JoeyShepard/RPN_Calculator/images/RPN_calculator_schematic.png

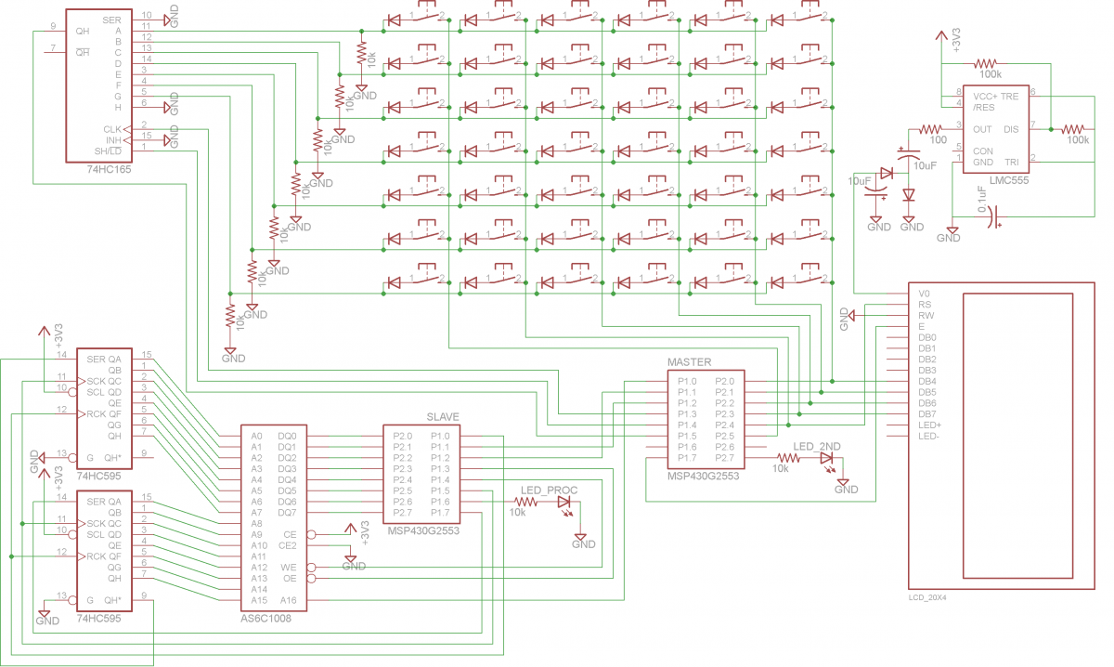
images/RPN_calculator_schematic.png
