JoeyShepard/RPN_Calculator/schematics/main.png

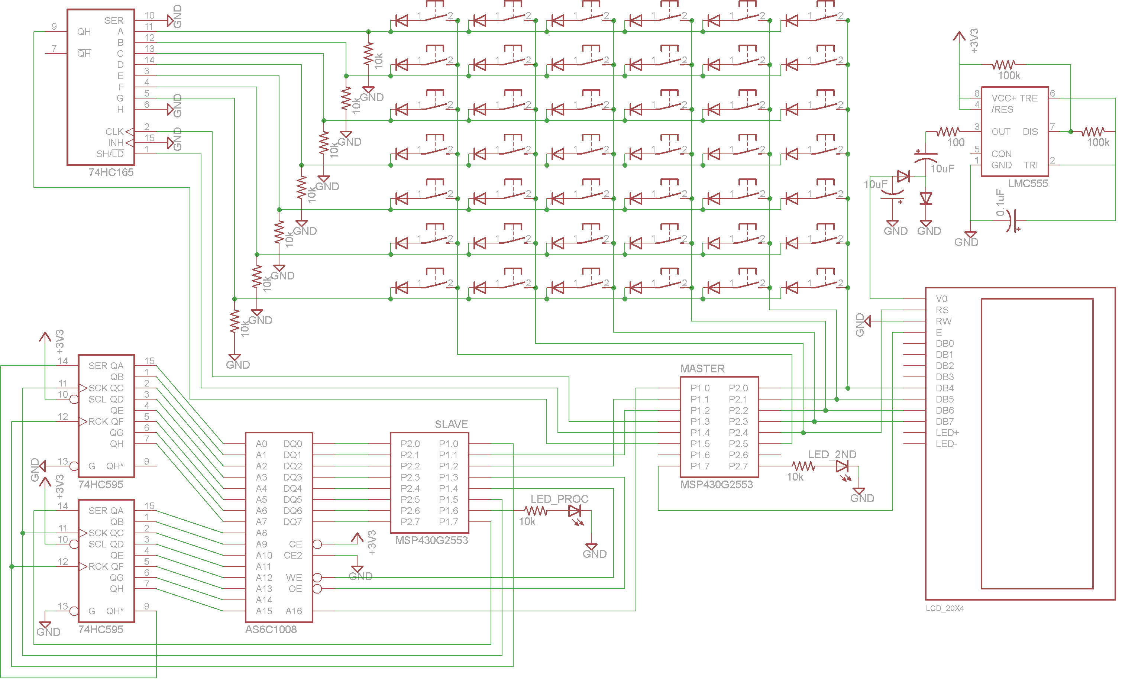
schematics/main.png
