JoeyShepard/RPN_Calculator/schematics/circuit_layout.sch

## EAGLE design schematics/circuit_layout.sch (2020-10-12)

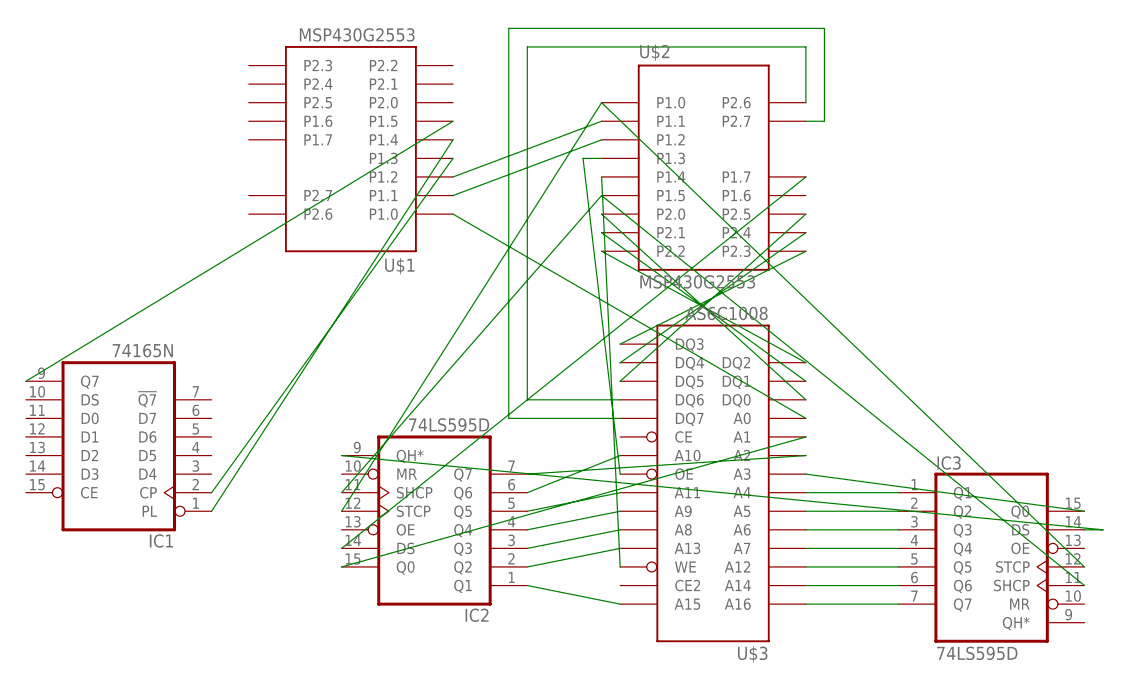
[picture p7: schematic circuit_layout.sch]

Parts:
IC1: 74165N; DIL16
IC2, IC3: 74LS595D; SO16
U$1, U$2: MSP430G2553
U$3: AS6C1008

Connections:
unnamed: IC3.7 (Q7), U$3.P$17 (A16)
unnamed: IC3.6 (Q6), U$3.P$15 (A14)
unnamed: IC3.5 (Q5), U$3.P$13 (A12)
unnamed: IC3.4 (Q4), U$3.P$8 (A7)
unnamed: IC3.3 (Q3), U$3.P$7 (A6)
unnamed: IC3.2 (Q2), U$3.P$6 (A5)
unnamed: IC3.1 (Q1), U$3.P$5 (A4)
unnamed: IC3.15 (Q0), U$3.P$4 (A3)
unnamed: IC2.1 (Q1), U$3.P$16 (A15)
unnamed: IC2.2 (Q2), U$3.P$14 (A13)
unnamed: IC2.3 (Q3), U$3.P$9 (A8)
unnamed: IC2.4 (Q4), U$3.P$10 (A9)
unnamed: IC2.5 (Q5), U$3.P$12 (A11)
unnamed: IC2.6 (Q6), U$3.P$11 (A10)
unnamed: IC2.7 (Q7), U$3.P$3 (A2)
unnamed: IC2.15 (Q0), U$3.P$2 (A1)
unnamed: U$2.P$9 (P2.0), U$3.P$20 (DQ0)
unnamed: U$2.P$10 (P2.1), U$3.P$21 (DQ1)
unnamed: U$2.P$11 (P2.2), U$3.P$22 (DQ2)
unnamed: U$2.P$12 (P2.3), U$3.P$23 (DQ3)
unnamed: U$2.P$13 (P2.4), U$3.P$24 (DQ4)
unnamed: U$2.P$14 (P2.5), U$3.P$25 (DQ5)
unnamed: U$2.P$15 (P2.6), U$3.P$26 (DQ6)
unnamed: U$2.P$16 (P2.7), U$3.P$27 (DQ7)
unnamed: IC2.9 (QH*), IC3.14 (DS)
unnamed: IC2.11 (SHCP), IC3.11 (SHCP), U$2.P$6 (P1.5)
unnamed: U$2.P$5 (P1.4), U$3.P$29 (WE)
unnamed: U$2.P$4 (P1.3), U$3.P$28 (OE)
unnamed: U$1.P$3 (P1.2), U$2.P$2 (P1.1)
unnamed: U$1.P$2 (P1.1), U$2.P$3 (P1.2)
unnamed: IC2.12 (STCP), IC3.12 (STCP), U$2.P$1 (P1.0)
unnamed: U$1.P$1 (P1.0), U$3.P$1 (A0)
unnamed: IC1.2 (CP), U$1.P$4 (P1.3)
unnamed: IC1.1 (PL), U$1.P$5 (P1.4)
unnamed: IC1.9 (Q7), U$1.P$6 (P1.5)
unnamed: IC2.14 (DS), U$2.P$8 (P1.7)
