JoeyShepard/RPN_Calculator/schematics/main.sch

## EAGLE design schematics/main.sch (2020-10-12)

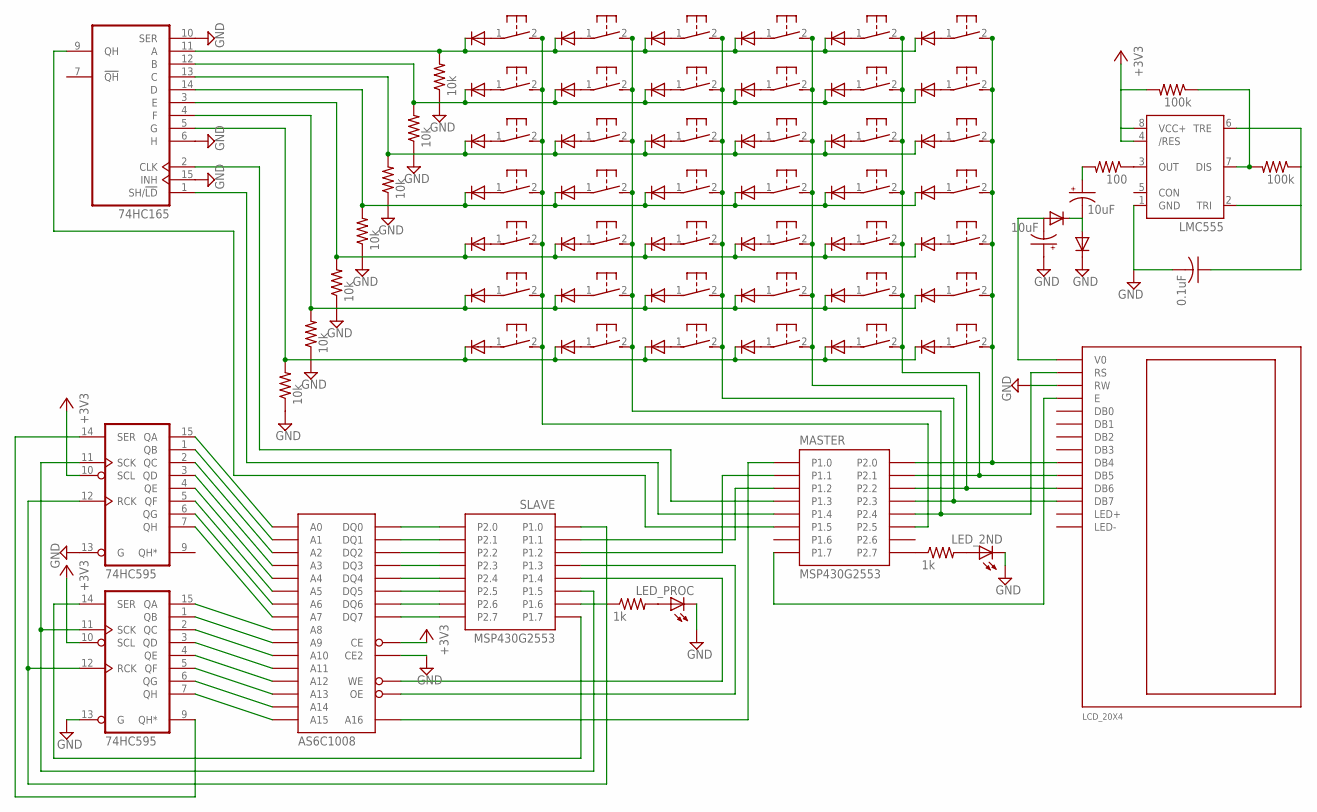
[picture p8: schematic main.sch]

Parts:
C2: 0.1uF; C025-024X044
C4, C5: 10uF; 085CS_1AW
D1, D2, D3, D4, D5, D6, D7, D8, D9, D10, D11, D12, D13, D14, D15, D16, D17, D18, D19, D20, D21, D22, D23, D24, D25, D26, D27, D28, D29, D30, D31, D32, D33, D34, D35, D36, D37, D38, D39, D40, D41, D42, D45, D46: 1N4148DO35-7; DO35-7
IC1: 74HC165; DIL16
IC2: LMC555; DIL-08
IC3, IC4: 74HC595; DIL16
LED_2ND: SFH482
LED_PROC: SFH482
MASTER: MSP430G2553
R1, R12: 1k; 0204V
R2, R3, R4, R5, R6, R7, R8: 10k; 0204V
R9, R10: 100k; 0204V
R11: 100; 0204V
S1, S2, S3, S4, S5, S6, S7, S8, S9, S10, S11, S12, S13, S14, S15, S16, S17, S18, S19, S20, S21, S22, S23, S24, S25, S26, S27, S28, S29, S30, S31, S32, S33, S34, S35, S36, S37, S38, S39, S40, S41, S42: 31-XX; B3F-31XX
SLAVE: MSP430G2553
U$1: LCD_20X4
U$2: AS6C1008

Connections:
+3V3: IC2.4 (/RES), IC2.8 (VCC+), IC3.10 (SCL), IC4.10 (SCL), R10.2, U$2.P$18 (CE)
GND: C2.2, C5.+, D45.C, IC1.6 (H), IC1.10 (SER), IC1.15 (INH), IC2.1 (GND), IC3.13 (G), IC4.13 (G), LED_2ND.K (C), LED_PROC.K (C), R2.1, R3.1, R4.1, R5.1, R6.1, R7.1, R8.1, U$1.P$15 (RW), U$2.P$19 (CE2)
unnamed: MASTER.P$16 (P2.7), R1.1
unnamed: LED_2ND.A, R1.2
unnamed: MASTER.P$9 (P2.0), S6.2 (S), S12.2 (S), S18.2 (S), S24.2 (S), S30.2 (S), S36.2 (S), S38.2 (S), U$1.P$5 (DB4)
unnamed: MASTER.P$10 (P2.1), S5.2 (S), S11.2 (S), S17.2 (S), S23.2 (S), S29.2 (S), S35.2 (S), S37.2 (S), U$1.P$6 (DB5)
unnamed: MASTER.P$11 (P2.2), S1.2 (S), S7.2 (S), S13.2 (S), S19.2 (S), S25.2 (S), S31.2 (S), S39.2 (S), U$1.P$7 (DB6)
unnamed: MASTER.P$12 (P2.3), S2.2 (S), S8.2 (S), S14.2 (S), S20.2 (S), S26.2 (S), S32.2 (S), S40.2 (S), U$1.P$8 (DB7)
unnamed: MASTER.P$8 (P1.7), U$1.P$11 (E)
unnamed: MASTER.P$13 (P2.4), S3.2 (S), S9.2 (S), S15.2 (S), S21.2 (S), S27.2 (S), S33.2 (S), S41.2 (S), U$1.P$14 (RS)
unnamed: D2.A, S38.1
unnamed: D1.A, S6.1
unnamed: D1.C, D3.C, D9.C, D10.C, D11.C, D12.C, IC1.12 (B), R3.2
unnamed: D2.C, D4.C, D5.C, D6.C, D7.C, D8.C, IC1.11 (A), R2.2
unnamed: D5.A, S37.1
unnamed: D3.A, S5.1
unnamed: D9.A, S7.1
unnamed: D10.A, S8.1
unnamed: D4.A, S1.1
unnamed: D11.A, S9.1
unnamed: D6.A, S2.1
unnamed: D12.A, S10.1
unnamed: D7.A, S3.1
unnamed: D13.A, S12.1
unnamed: D8.A, S4.1
unnamed: D13.C, D14.C, D15.C, D16.C, D17.C, D18.C, IC1.13 (C), R4.2
unnamed: D14.A, S11.1
unnamed: D15.A, S13.1
unnamed: D16.A, S14.1
unnamed: D17.A, S15.1
unnamed: D18.A, S16.1
unnamed: D19.A, S18.1
unnamed: D19.C, D20.C, D21.C, D22.C, D23.C, D24.C, IC1.14 (D), R5.2
unnamed: D20.A, S17.1
unnamed: D21.A, S19.1
unnamed: D22.A, S20.1
unnamed: D23.A, S21.1
unnamed: D24.A, S22.1
unnamed: D25.A, S24.1
unnamed: D25.C, D26.C, D27.C, D28.C, D29.C, D30.C, IC1.3 (E), R6.2
unnamed: D26.A, S23.1
unnamed: D27.A, S25.1
unnamed: D28.A, S26.1
unnamed: D29.A, S27.1
unnamed: D30.A, S28.1
unnamed: D31.A, S30.1
unnamed: D31.C, D32.C, D33.C, D34.C, D35.C, D36.C, IC1.4 (F), R7.2
unnamed: D32.A, S29.1
unnamed: D33.A, S31.1
unnamed: D34.A, S32.1
unnamed: D35.A, S33.1
unnamed: D36.A, S34.1
unnamed: D37.A, S36.1
unnamed: D37.C, D38.C, D39.C, D40.C, D41.C, D42.C, IC1.5 (G), R8.2
unnamed: D38.A, S35.1
unnamed: D39.A, S39.1
unnamed: D40.A, S40.1
unnamed: D41.A, S41.1
unnamed: D42.A, S42.1
unnamed: IC1.2 (CLK), MASTER.P$4 (P1.3)
unnamed: IC1.1 (SH/!LD), MASTER.P$5 (P1.4)
unnamed: IC1.9 (QH), MASTER.P$6 (P1.5)
unnamed: IC2.7 (DIS), R9.2, R10.1
unnamed: MASTER.P$1 (P1.0), U$2.P$17 (A16)
unnamed: C2.1, IC2.2 (TRI), IC2.6 (TRE), R9.1
unnamed: MASTER.P$14 (P2.5), S4.2 (S), S10.2 (S), S16.2 (S), S22.2 (S), S28.2 (S), S34.2 (S), S42.2 (S)
unnamed: IC2.3 (OUT), R11.1
unnamed: C4.+, R11.2
unnamed: MASTER.P$3 (P1.2), SLAVE.P$2 (P1.1)
unnamed: C4.-, D45.A, D46.C
unnamed: C5.-, D46.A, U$1.P$16 (V0)
unnamed: MASTER.P$2 (P1.1), SLAVE.P$3 (P1.2)
unnamed: SLAVE.P$9 (P2.0), U$2.P$20 (DQ0)
unnamed: SLAVE.P$10 (P2.1), U$2.P$21 (DQ1)
unnamed: SLAVE.P$11 (P2.2), U$2.P$22 (DQ2)
unnamed: SLAVE.P$12 (P2.3), U$2.P$23 (DQ3)
unnamed: SLAVE.P$13 (P2.4), U$2.P$24 (DQ4)
unnamed: SLAVE.P$14 (P2.5), U$2.P$25 (DQ5)
unnamed: SLAVE.P$15 (P2.6), U$2.P$26 (DQ6)
unnamed: SLAVE.P$16 (P2.7), U$2.P$27 (DQ7)
unnamed: SLAVE.P$4 (P1.3), U$2.P$28 (OE)
unnamed: SLAVE.P$5 (P1.4), U$2.P$29 (WE)
unnamed: IC3.12 (RCK), IC4.12 (RCK), R12.1, SLAVE.P$1 (P1.0), SLAVE.P$7 (P1.6)
unnamed: IC3.11 (SCK), IC4.11 (SCK), SLAVE.P$6 (P1.5)
unnamed: IC4.14 (SER), SLAVE.P$8 (P1.7)
unnamed: LED_PROC.A, R12.2
unnamed: IC3.14 (SER), IC4.9 (QH*)
unnamed: IC3.15 (QA), U$2.P$1 (A0)
unnamed: IC3.1 (QB), U$2.P$2 (A1)
unnamed: IC3.2 (QC), U$2.P$3 (A2)
unnamed: IC3.3 (QD), U$2.P$4 (A3)
unnamed: IC3.4 (QE), U$2.P$5 (A4)
unnamed: IC3.5 (QF), U$2.P$6 (A5)
unnamed: IC3.6 (QG), U$2.P$7 (A6)
unnamed: IC3.7 (QH), U$2.P$8 (A7)
unnamed: IC4.15 (QA), U$2.P$9 (A8)
unnamed: IC4.1 (QB), U$2.P$10 (A9)
unnamed: IC4.2 (QC), U$2.P$11 (A10)
unnamed: IC4.3 (QD), U$2.P$12 (A11)
unnamed: IC4.4 (QE), U$2.P$13 (A12)
unnamed: IC4.5 (QF), U$2.P$14 (A13)
unnamed: IC4.6 (QG), U$2.P$15 (A14)
unnamed: IC4.7 (QH), U$2.P$16 (A15)
